rob-mau/delteron/report.pdf

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

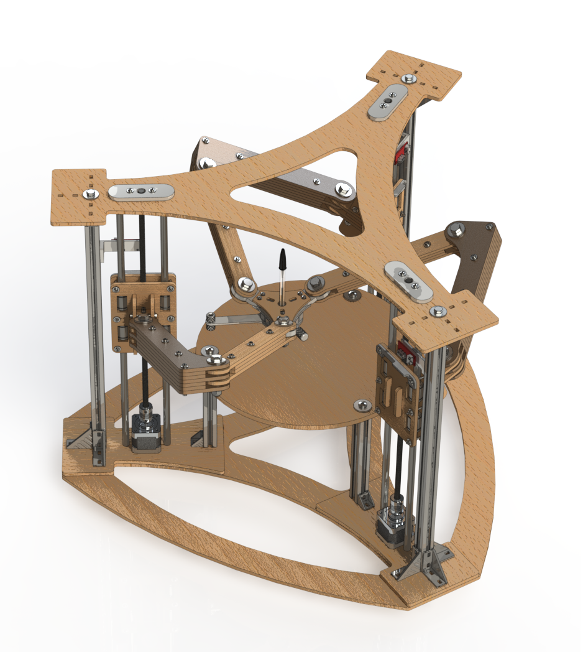
[picture p1: figure]

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

## 1 Introduzione

Il presente elaborato raccoglie le procedure seguite e i risultati ottenuti durante gli stadi di progettazione e costruzione di un prototipo di robot Delteron in grado di disegnare. Il robot riceve in ingresso una sequenza di istruzioni in G-code che codicano l'immagine da tracciare (prodotte in precedenza da un software di graca vettoriale), le quali vengono opportunamente elaborate e trasformate in comandi da inviare agli attuatori. Ad una preliminare fase di studio cinematico della struttura seguono le fasi di modellazione CAD e realizzazione dei componenti, sfruttando i materiali e le tecnologie di produzione disponibili in laboratorio. Si passa dunque alla scelta della componentistica elettronica e degli azionamenti e, inne, alla stesura del codice che gestisce la macchina.

## 2 Geometria

Il Delteron (talvolta chiamato Tripteron collineare) è un manipolatore a cinematica parallela: è costituito cioè da più catene cinematiche seriali poste "in parallelo", che collegano il telaio all'organo mobile terminale (end-eector). In una simile struttura le relazioni che esprimono i vincoli di chiusura delle catene generano delle dipendenze tra alcune delle variabili di giunto e quindi, tipicamente, non tutti i giunti sono attuati. Uno dei vantaggi è quello di poter posizionare gli attuatori sul basamento, rendendo la parte mobile del robot più leggera e dotata di una più spiccata destrezza nei movimenti.

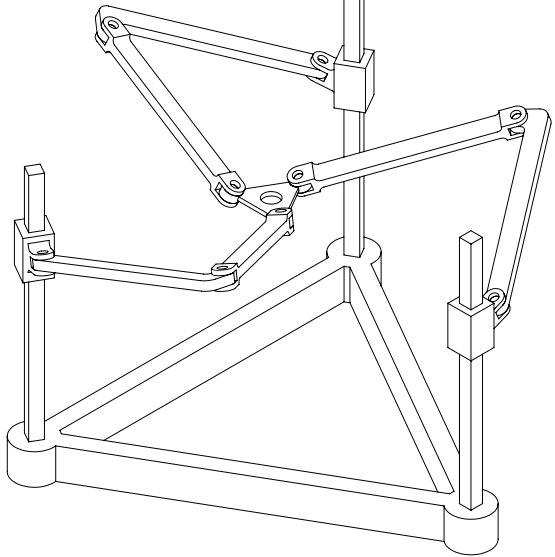
[picture p2: figure]

Figura 1: geometria del robot.

Come il nome stesso suggerisce, il Delteron è una sorta di fusione tra la geometria di un robot Delta e quella di un Tripteron. Ciascuna delle tre identiche catene cinematiche che concorrono alla movimentazione dell'end-eector è costituita da tre elementi, vincolati

2

tra loro mediante coppie rotoidali. Alle estremità della catena, da un lato, un giunto prismatico (attuato) collega questa al telaio, mentre, dall'altro, un ulteriore giunto rotoidale la collega all'end-eector. Gli assi delle cerniere di una stessa catena sono tra loro paralleli, ma inclinati rispetto ad una retta verticale di un angolo δ (Figura 2).

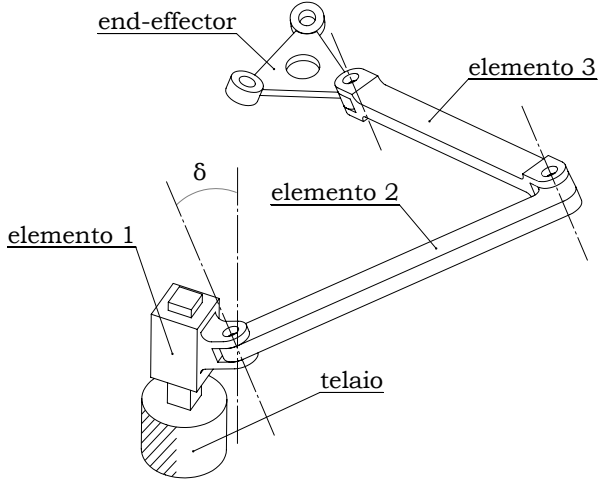
[picture p3: figure]
elemento 1; elemento 2; elemento 3; telaio; end-effector

Figura 2: geometria della catena cinematica PRRR.

Così vincolato l'end-eector possiede solamente i tre gradi di libertà traslazionali e il suo orientamento nello spazio rimane immutato al variare della congurazione assunta dal robot. Poiché nella congurazione coi giunti prismatici alla stessa altezza, per simmetria della struttura, l'end-eector si trova posizionato con un orientamento orizzontale, per quanto detto sopra, sarà orientato orizzontalmente in ogni altra possibile congurazione.

Per arontare lo studio della cinematica inversa è conveniente, in questo caso, adottare un approccio geometrico in quanto, seppur non rigoroso, snellisce la trattazione e fornisce una più immediata comprensione del sistema. Facendo riferimento alla Figura 3, il problema della cinematica inversa si traduce nel calcolo della coordinata verticale ζ del punto H, variabile associata al giunto prismatico, avendo noto il vettore posizione del punto E, centro dell'end-eector. La soluzione può essere ottenuta facilmente intersecando il piano perpendicolare all'asse delle cerniere e passante per il vertice V (la cui posizione relativa ad E è perfettamente nota considerando l'invarianza dell'orientamento dell'end-eector) con l'asse di scorrimento della coppia prismatica. In formule:

E = [xe, ye, ze]

la posizione del vertice V è data da:

V = E + (V − E)
[xv, yv, zv] = [xe, ye, ze] + [0, d, 0] = [xe, ye + d, ze]

il versore direttore dagli assi delle cerniere è:

~n = [0, − sin δ, cos δ]

3

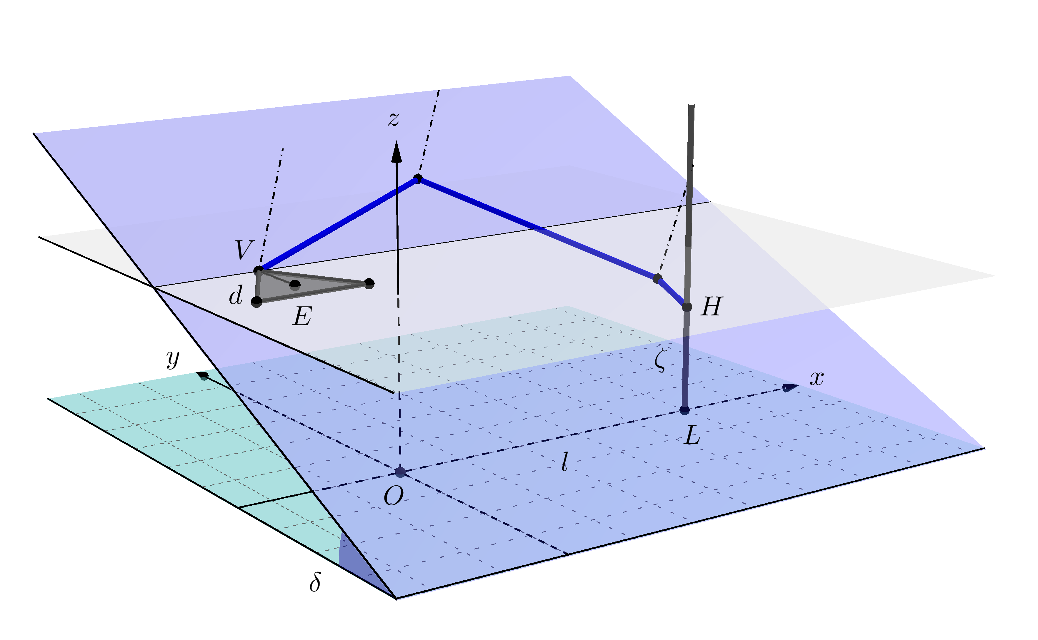
[picture p4: figure]

Figura 3: astrazione geometrica del robot.

l'equazione che denisce il luogo dei punti P = [x, y, z] appartenenti al piano passante per V e normale a ~n è:

(P − V ) • ~n = 0
⇓
[x − xe, y − ye − d, z − ze] • [0, − sin δ, cos δ] = 0 ⇓
z = ze + tan δ (y − ye − d)

il sistema di equazioni che denisce il luogo dei punti P = [x, y, z] appartenenti all'asse della coppia prismatica (ottenuto come intersezione di due piani verticali) è:
(
(P − L) • ~i = 0
(P − L) • ~j = 0

⇓
(
[x − l, y, z] • [1, 0, 0] = 0 [x − l, y, z] • [0, 1, 0] = 0

⇓
(
x = l
y = 0

4

mettendo insieme le equazioni appena ricavate, cioè intersecando i luoghi geometrici sopra deniti, ottengo inne la soluzione cercata, ovvero le coordinate del punto H e, in particolare, la sua quota ζ:

zh = ze + tan δ (yh − ye − d)

xh = l
yh = 0
⇓

ζ

def = zh = ze − tan δ (ye + d)

Analogamente è possibile ottenere la coordinata verticale dei punti che individuano la posizione della coppia prismatica sugli altri due assi del robot (basta considerare la precedente geometria ruotata di 2/3 π rad e 4/3 π rad).
Adottando per tali coordinate i simboli ζ1, ζ2, ζ3 (procedendo in senso antiorario), le equazioni che risolvono la cinematica inversa del robot sono:

ζ1 = ze − tan δ (d + ye)

ζ2 = ze − tan δ (d −

√
3 / 2 xe − 1 / 2 ye)

ζ3 = ze − tan δ (d +

√
3 / 2 xe − 1 / 2 ye)

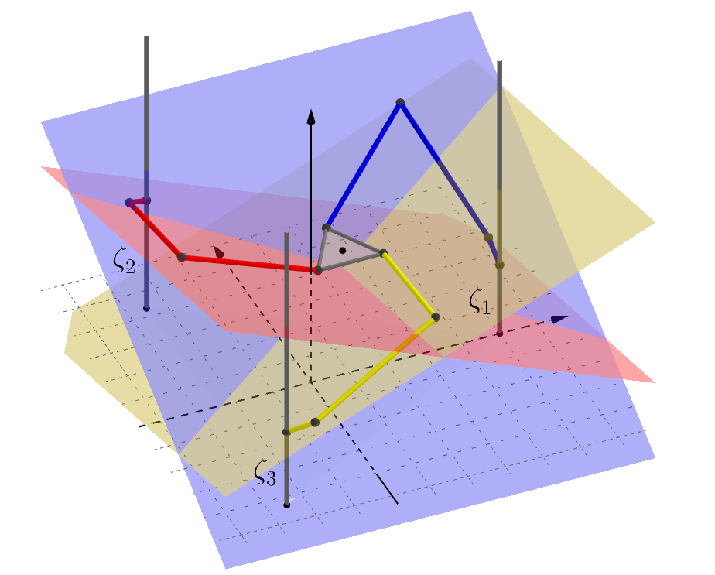
[picture p5: figure]

Figura 4: interpretazione geometrica delle equazioni della cinematica inversa.

È interessante notare come la soluzione sia del tutto indipendente da gran parte dei parametri geometrici che caratterizzano la struttura. Essa infatti necessita della conoscenza dei soli parametri d (distanza tra V e E) e δ (angolo di inclinazione dell'asse dei giunti rotoidali rispetto alla verticale). Il valore di l (distanza dell'asse del giunto prismatico dall'origine O), per quanto a prima vista possa sembrare necessario, è in

5

realtà irrilevante. Infatti, sempre in riferimento alla Figura 3, il versore normale al piano inclinato ha componente nulla lungo x e quindi il piano intercetterà l'asse della guida sempre alla stessa quota se quest'ultimo viene fatto traslare in direzione parallela ad x stesso (variazione del valore di l).
Le relazioni ottenute, inoltre, godono della proprietà di linearità e possono allora essere riscritte nella più compatta forma matriciale:

ζ1
ζ2
ζ3
- =

0 − tan δ 1
√
3/2 tan δ 1/2 tan δ 1
−

√
3/2 tan δ 1/2 tan δ 1

xe
ye
ze
- − d tan δ

1
1
1

dalla quale sono facilmente ottenibili le relazioni inverse (cinematica diretta):

xe
ye
ze
- =

1
3 tan δ

0

√
3 −

√
3
−2 | 1 | 1
tan δ tan δ tan δ

ζ1
ζ2
ζ3
- + d tan δ

0
0
1

Queste ultime sono utili per visualizzare lo spazio di lavoro del manipolatore e, di conseguenza, per operare una scelta sul valore da assegnare al parametro δ.
Come visibile in Figura 5, aumentando il valore dell'angolo di inclinazione dei bracci, a parità di ogni altro parametro progettuale, lo spazio di lavoro tende a ridursi. Per questo manipolatore si è scelto di porre δ = π/8. Il valore del parametro d invece è stato valutato in modo tale da poter garantire sull'end-eector spazio suciente ad accogliere i cuscinetti e il sistema di serraggio della penna. Le lunghezze dei link che costituiscono i bracci, pur non inuenzando direttamente le equazioni della cinematica, devono essere scelte in modo da permettere al robot di raggiungere tutte le posizioni previste evitando congurazioni singolari o strutturalmente impossibili.

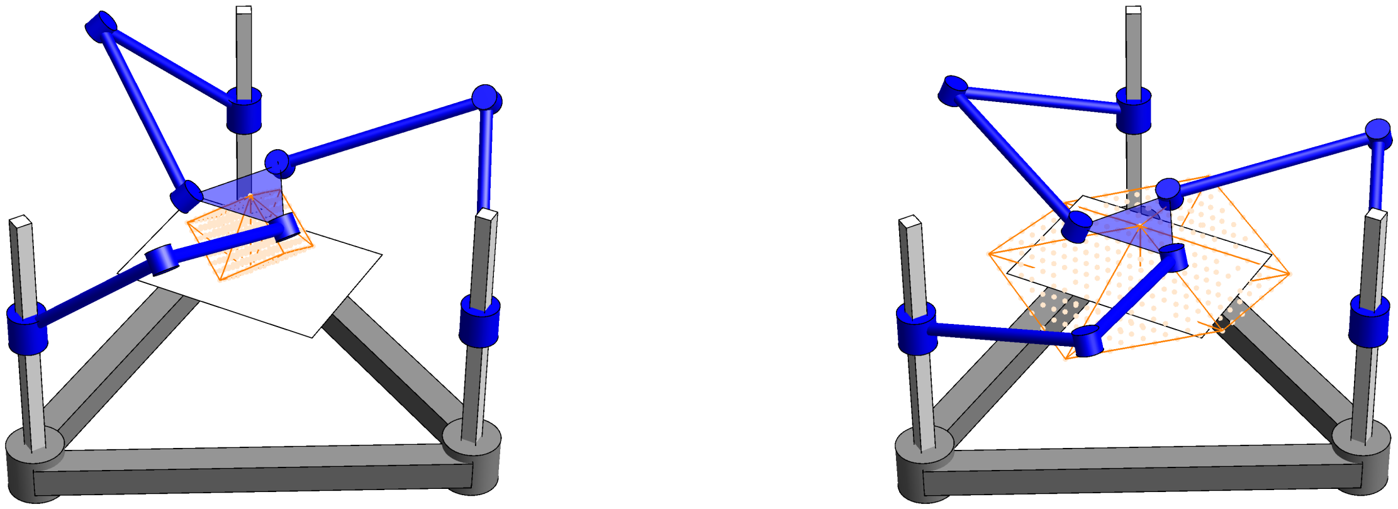
[picture p6: figure]

Figura 5: spazio di lavoro: a sinistra δ = π/4, a destra δ = π/8.

6

3 | Hardware
3.1 | Materiali e Tecniche di Produzione

La struttura meccanica è stata realizzata principalmente in legno multistrato, potendo far adamento in laboratorio su una macchina per il taglio laser a controllo numerico, mentre componenti piccole o di geometria elaborata sono state realizzate in acido polilattico (PLA) con una stampante 3D, usando la tecnica di modellazione a deposizione fusa (FDM): un lamento plastico fuso è depositato da un ugello estrusore su strati successivi, che, disponendosi l'uno sopra l'altro, creano il volume del pezzo.
Per migliorare la robustezza della struttura, sono stati impiegati inoltre prolati e componenti modulari in alluminio Bosch Rexroth.

Tutte le parti del robot sono state disegnate con l'ausilio di Solidworks. I le .sldprt (solidworks part) generati dal software CAD, per poter essere letti ed elaborati, vanno convertiti in .dxf (drawing exchange format) per la macchina a taglio laser e .stl (standard triangulation language) per la stampante 3D.

Per gestire la stampante 3D si è usato il software Repetier-Host, il quale legge il le .stl, che è sostanzialmente una rappresentazione discretizzata mediante triangoli della supercie del modello, e, attraverso un programma di slicing (Slic3r o CuraEngine), suddivide l'oggetto in strati (layer). Per ogni strato genera poi le traiettorie che l'estrusore dovrà seguire (Figura 6). In questa fase è possibile settare diversi parametri, come lo spessore dei layer o la densità di riempimento del pezzo. In output il programma produce un le in G-code che invia direttamente alla macchina. Si veda il video nella cartella "Media" per un esempio di stampa.

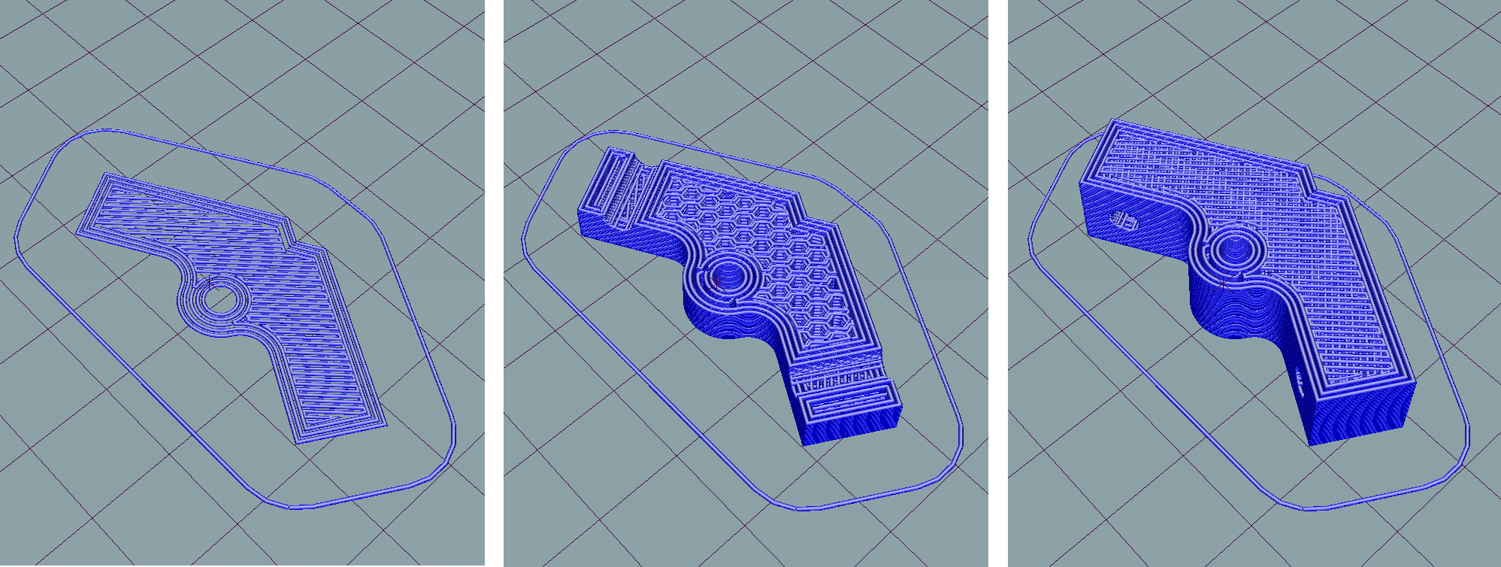
[picture p7: figure]

Figura 6: dierenti layer del pezzo "gria".

In Figura 7 sono riportati due esempi di pezzi realizzati con le tecniche appena esposte. A sinistra sono ragurati i modelli disegnati in Solidworks, a destra ciò che è stato prodotto con le lavorazioni.

7

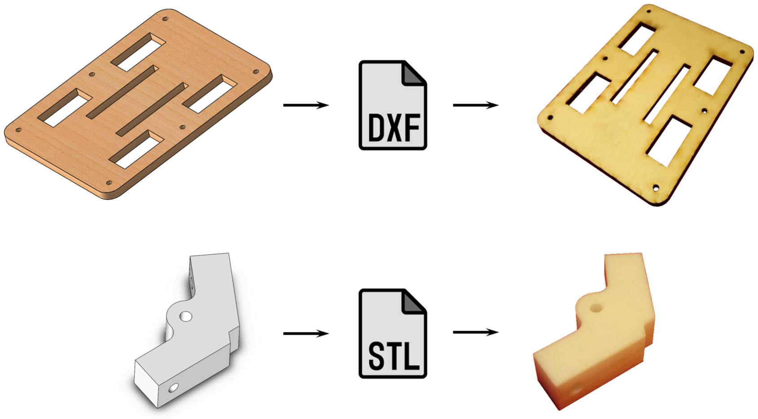
[picture p8: figure]

Figura 7: schema di realizzazione dei pezzi.

3.2 Soluzioni Costruttive

Il robot è ottenuto assemblando tra loro pezzi che, a causa del particolare processo di realizzazione (taglio laser), possono denirsi a ragion veduta "bidimensionali". Questi, impilandosi e incastrandosi tra loro come in un puzzle tridimensionale, generano le forme "solide". Per favorire il disassemblaggio o la sostituzione dei pezzi danneggiati, tutti gli elementi sono tenuti insieme attraverso collegamenti smontabili.

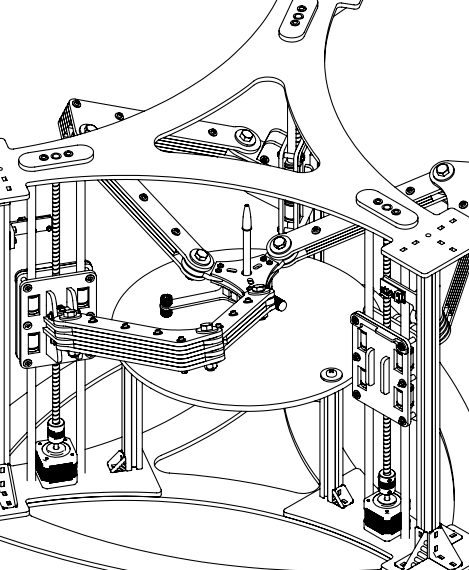
[picture p9: figure]

Figura 8: modello Solidworks del robot.

Nelle sottosezioni a seguire vengono mostrate le soluzioni costruttive adottate per la realizzazione di alcuni degli elementi più delicati della struttura: i giunti e il sistema di serraggio della penna.

8

Giunto Rotoidale

Il giunto rotoidale è stato realizzato mediante l'utilizzo di cuscinetti radiali a sfere 8 × 22 × 7 mm il cui anello esterno è stato inserito con interferenza nell'apposito alloggiamento ricavato su uno dei due link da connettere. L'anello interno invece entra in contatto col secondo link attraverso la frapposizione di rosette. Il tutto è opportunamente serrato con una vite M8. Per rendere lo snodo più rigido si sono utilizzati due cuscinetti per asse, realizzando una congurazione nella quale fogli di legno appartenenti ad entrambi i link si alternano lungo lo spessore del giunto (Figura 9).

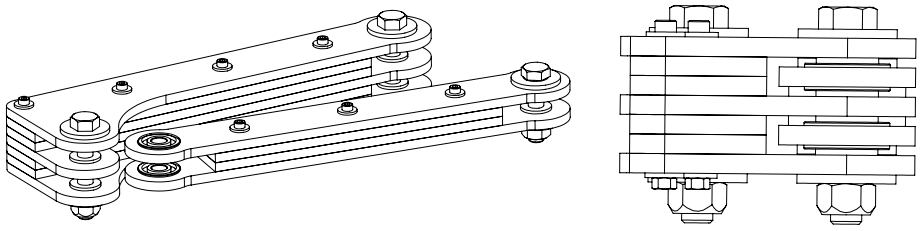
[picture p10: figure]

Figura 9: dettaglio del giunto rotoidale.

Giunto Prismatico

Il giunto prismatico è stato costruito impiegando cuscinetti a sfere lineari 10 × 19 × 29 mm che scorrono lungo barre in acciaio M10. I cuscinetti sono stati alloggiati in fori rettangolari ritagliati su due piastrine, le quali impacchettano questi tenendoli fermi in posizione. Poiché la trasmissione del moto è realizzata attraverso un accoppiamento vite-madrevite, il blocco accoglie al suo interno un dado che andrà ad avvitarsi su una barra lettata M8, il cui moto è reso solidale all'albero del motore per mezzo di un coupler essibile. A completamento del pezzo, tramite un sistema di incastri, è stato aggiunto il supporto per i cuscinetti radiali (che costituiscono parte del primo snodo rotoidale), il quale impone l'inclinazione dell'angolo δ al piano su cui idealmente giacerà l'intero braccio. Alcuni dettagli sono visibili in Figura 10.

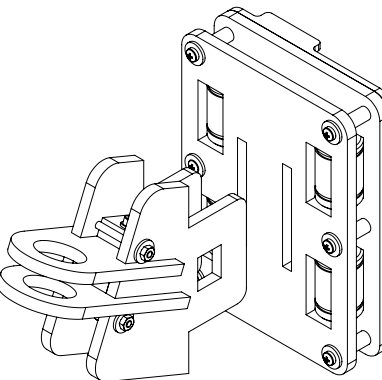
[picture p11: figure]

Figura 10: dettaglio del giunto prismatico.

9

Gripper

Il gripper è l'elemento preposto al posizionamento della penna ed è l'unico interamente realizzato in PLA per consentire alle parti in moto relativo un più uido scorrimento. Esso svolge sia la funzione di centraggio che quella di serraggio .
La prima è adempiuta da un sistema di grie scorrevoli movimentate da una ruota su cui son state ricavate delle asole curve. Ruotando in senso orario il braccio della ruota (se osservato dall'alto), le asole allontanano i perni su cui sono vincolate le grie e il meccanismo si apre. Un anello elastico (in questo caso una sezione di camera d'aria di bicicletta), montato su delle pulegge avvitate sui perni, provvede invece alla chiusura automatica del dispositivo. Da notare che la sagoma dell'asola, in corrispondenza del punto di massima apertura, consente il movimento dei perni solo in direzione tangenziale alla ruota e, poiché le forze elastiche spingono invece in direzione radiale, il meccanismo rimane bloccato nella congurazione aperta, permettendo un comodo posizionamento della penna. Dopodiché basta ruotare leggermente il braccio per far scattare il movimento di chiusura (si veda il video nella cartella "Media").
La seconda funzione è invece svolta da una vite che attraversa trasversalmente il volume di una delle grie ed entra in contatto con la supercie laterale della penna. La vite, stringendo leggermente, impedisce che la penna possa accidentalmente slarsi a causa delle forze di contatto col piano del foglio che tenderebbero a sollevarla. Una rappresentazione del dispositivo smontato è riportata in Figura 11.

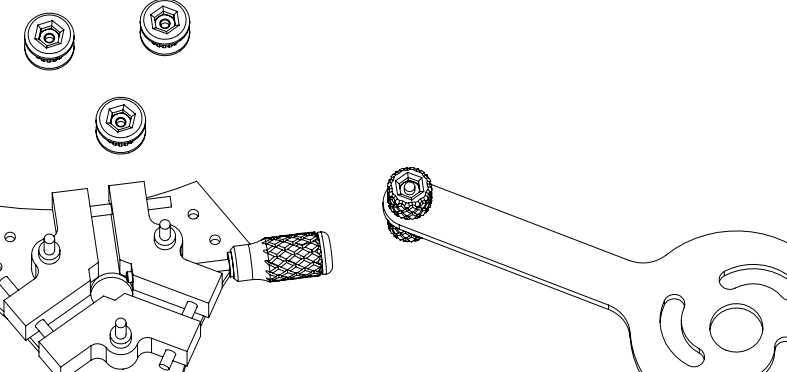
[picture p12: figure]

Figura 11: dettaglio del gripper.

3.3 Componentistica Elettronica e Azionamenti

Per quanto riguarda l'elettronica si è scelto di utilizzare una scheda Arduino Uno, aancata da una CNC shield volta ad accogliere tre driver Pololu A4988 per motori stepper. A completare la dotazione ci sono tre motori stepper Nema 17 modello 17HS4401, tre endstop, i rispettivi cavi di collegamento e un alimentatore da 12 V in grado di erogare corrente suciente ad alimentare i tre motori. In Figura 12 sono riportati i vari elementi collegati tra loro e i pin della scheda Arduino coinvolti nello scambio di segnali.

| 10

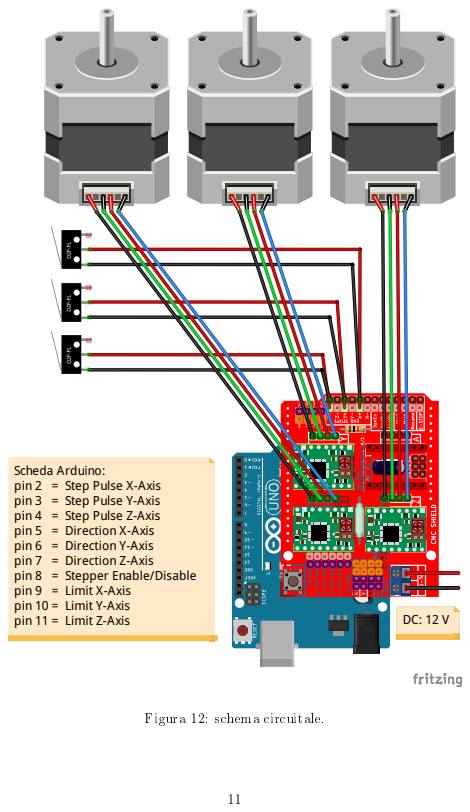
[picture p13: page 12]
pin 11 = Limit Z-Axis

Scheda Arduino:
pin 2 = Step Pulse X-Axis
pin 3 = Step Pulse Y-Axis
pin 4 = Step Pulse Z-Axis
pin 5 = Direction X-Axis
pin 6 = Direction Y-Axis
pin 7 = Direction Z-Axis
pin 8 = Stepper Enable/Disable
pin 9 = Limit X-Axis
pin 10 = Limit Y-Axis

Figura 12: schema circuitale.

## 4 Software

Il software consiste essenzialmente in due script cooperanti (uno in esecuzione sul PC, l'altro sulla scheda Arduino), che comunicano tra loro per mezzo di messaggi inviati attraverso la porta seriale.
L'obiettivo del programma è quello di leggere e interpretare, riga dopo riga, le istruzioni in G-code memorizzate in un le di testo e di far assumere ai motori le posizioni richieste, coordinandone il movimento. Così facendo l'end-eector si sposterà da un punto dello spazio al successivo tracciando un'approssimazione della traiettoria voluta. Più traiettorie daranno luogo a un disegno.

Per far ciò il primo passo consiste nel trasformare un disegno in una sequenza di istruzioni che codicano l'insieme di punti su cui dovrà posizionarsi l'end-eector. Ciò può essere ottenuto facilmente con un software di graca vettoriale, come ad esempio Inkscape. L'output del programma sarà un le di testo con righe del seguente tipo:

G01 X20.813110 Y-17.187250 Z-0.500000

G01 X20.293060 Y-19.078350 Z-0.500000

Python

Ottenuto il le bisogna adesso scrivere un programma per il PC che legga il testo un'istruzione per volta e comunichi la stinga di caratteri ad Arduino tramite porta seriale. In questa fase viene a crearsi un problema di sincronizzazione: il PC infatti, una volta comunicato il comando, deve attendere che Arduino esegua le elaborazioni sui dati ricevuti e posizioni i motori dove richiesto prima di poter inviare il comando successivo. Per tener conto di ciò il programma, dopo aver inviato l'istruzione, si mette in ascolto sulla porta seriale e attende nché non riceve il messaggio "Positioned" da parte della scheda. Dopodiché il ciclo si ripete uguale a se stesso no a completa lettura del le. Questo script è stato scritto in Python ed è accessibile nella cartella "Python" col nome "serial_com". Può essere lanciato tramite l'interfaccia graca IDLE.

Arduino - C

Ora che Arduino può ricevere l'istruzione in G-code, ciò che resta da fare è scrivere un programma in C da caricare sulla scheda che permetta di estrarre dalla stringa di caratteri le informazioni numeriche relative alla posizione dell'end-eector, le usi per calcolarsi gli spostamenti angolari dei motori attraverso le equazioni della cinematica inversa e invii ai driver segnali contenenti informazioni su direzione del moto e numero di passi da far eettuare ai motori stepper.

Di seguito viene riportato lo script in pseudo-linguaggio in modo da chiarire le operazioni fondamentali che il microcontrollore esegue.
All'avvio viene lanciata la funzione homing. Questa è una procedura che porta il robot in una congurazione nota (home), usata come riferimento per ogni posizionamento

12 futuro. Sostanzialmente i motori iniziano a ruotare facendo traslare le guide prismatiche verso l'alto nché queste non incontrano gli endstop, i quali innescano l'arresto di ogni movimento. Ovviamente gli endstop vanno ssati sulla struttura con una buona precisione in modo che risultino tutti alla stessa altezza.
Dopodiché si entra in un loop in cui Arduino si pone in ascolto sulla seriale e non appena arriva un nuovo comando esegue una serie di operazioni ben denite. Per prima cosa avvia la procedura di parsing. Questa consiste nel frammentare la stringa ricevuta in sottoparti. Il carattere che indica il punto in cui eettuare la separazione è lo spazio. Data la struttura tipica di una riga di G-code ci si trova quindi con un frammento costituito da una lettera seguita da un numero, e.g. "Y-19.078350". Interpretata la lettera, questa viene eliminata e ciò che resta (caratteri che rappresentano numeri) viene convertito in una variabile numerica vera e propria. Così per ogni frammento generato. Ottenute le variabili numeriche il codice prosegue col calcolo della cinematica inversa e col posizionamento dei motori. Quest'ultima operazione viene eettuata usando delle comode funzioni denite nelle librerie Accelstepper.h e Multistepper.h di Arduino che semplicemente generano dei segnali HIGH/LOW da inviare sui pin STEP e DIR di ciascun driver. Ad ogni transizione basso-alto sul canale STEP corrisponde l'avanzamento di un passo del motore, mentre il livello del segnale sul canale DIR denisce il senso orario o antiorario della rotazione. Inne la scheda comunica attraverso la seriale il termine delle proprie operazioni scrivendo la stringa di caratteri "Positioned".

void setup() { // esegue in avvio
inizializza pin;
inizializza motori;
inizializza seriale;

stampa su seriale: "Homing . . ."; avvia procedura di homing;
stampa su seriale: "Homing Completed"; stampa su seriale: "Start!";
}

void loop() { // esegue ciclicamente leggi da seriale;
if (è presente un nuovo comando) {
estrapola info numeriche dal comando; (parsing) stampa su seriale le info numeriche estrapolate;

calcola cinematica inversa;
posiziona i motori;
stampa su serale: "Positioned"; }
}

Nella cartella "Arduino" è disponibile lo sketch completo chiamato "delteron_code" pronto per essere caricato sulla scheda.

13

In gura 13 è riportato uno schema che illustra visivamente quanto nora esposto.

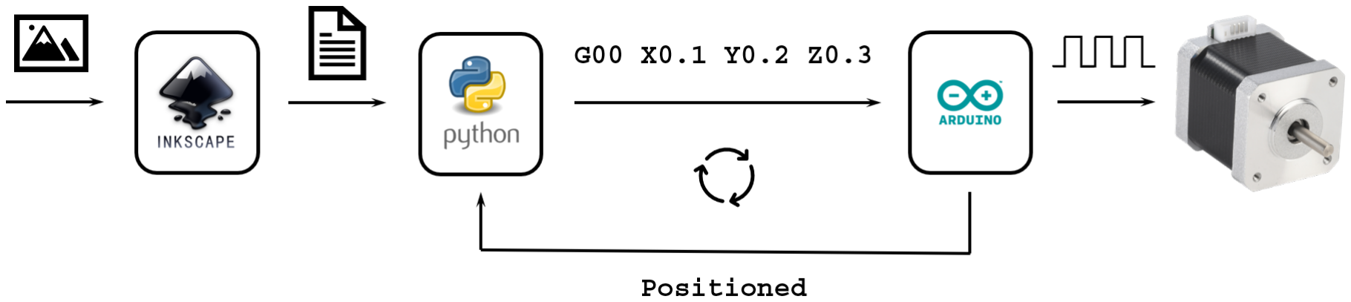
[picture p14: figure]

Figura 13

Nella cartella "Media" è possibile trovare il video del robot in funzione mentre è intento a tracciare i lineamenti di un volto.

## 5 Suggerimenti Pratici

Prima di avviare lo script in Python "serial_com" si consiglia di controllare il nome della porta seriale alla quale è connesso il dispositivo ed eventualmente, se diverso da quello riportato nel codice, modicarlo. Stessa cosa per quanto riguarda il nome del le G-code che rappresenta il disegno da tracciare.

port = 'COM6'
file_name = 'ritratto.ngc'

Prima di posizionare la penna sull'end-eector si suggerisce di mandare in esecuzione tramite lo script "serial_com" il le di testo "origin.ngc" contenuto nella cartella "Python". Questo le riporta un'unica istruzione in G-code: G00 X0.0 Y0.0 Z0.0. Quando eseguito, il comando fa posizionare l'end-eector in prossimità del piano di disegno. In questa posizione si può ssare la penna sul gripper facendo in modo che la punta sori la supercie del foglio. Controllare inoltre che il ripiano del foglio sia ben livellato.

Si consiglia poi, in fase di generazione del le G-code del disegno, di settare un valore di Z negativo ma piccolo in modulo (e.g. -0.5 mm) in modo che la punta della penna penetri nel foglio esercitando una leggera pressione.

Si suggerisce inne di usare un software per la visualizzazione dei listati di G-code (e.g. CAMotics) in modo da vericare in anticipo che tutte le istruzioni siano corrette e che il disegno sia ben posizionato e delle giuste dimensioni.

14
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
